nahveiga/black-widow/site/img/poster-video.jpg

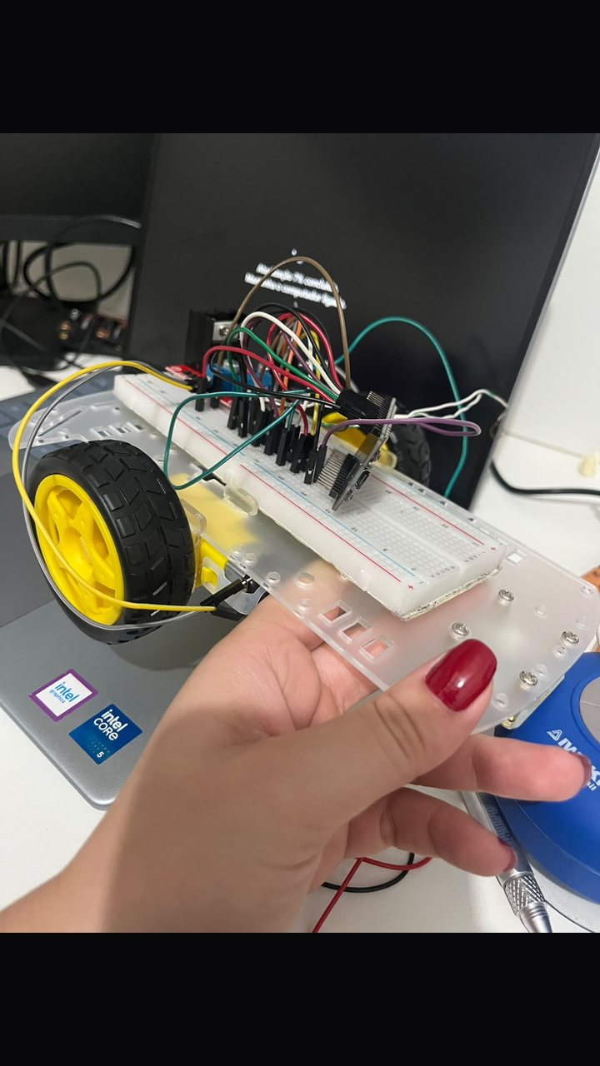
site/img/poster-video.jpg
