nahveiga/black-widow/site/img/prototipo.jpg

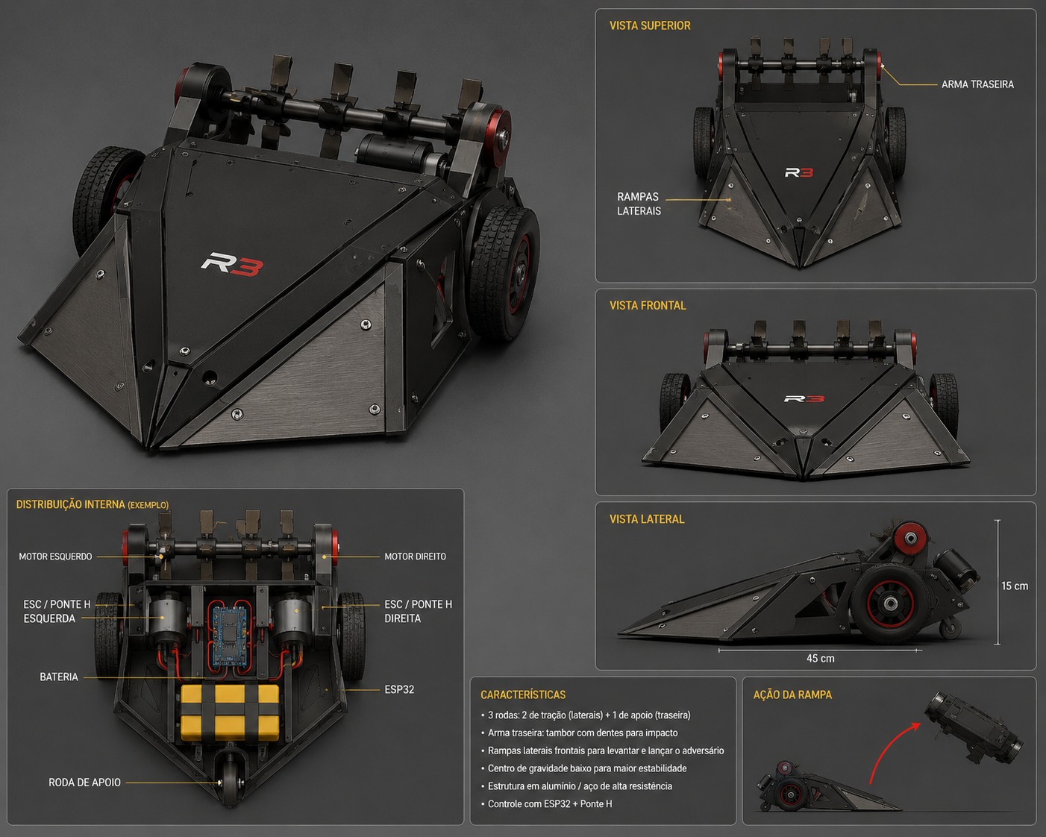
site/img/prototipo.jpg
