nahveiga/black-widow/files/Esquematico_Black_Widow.png

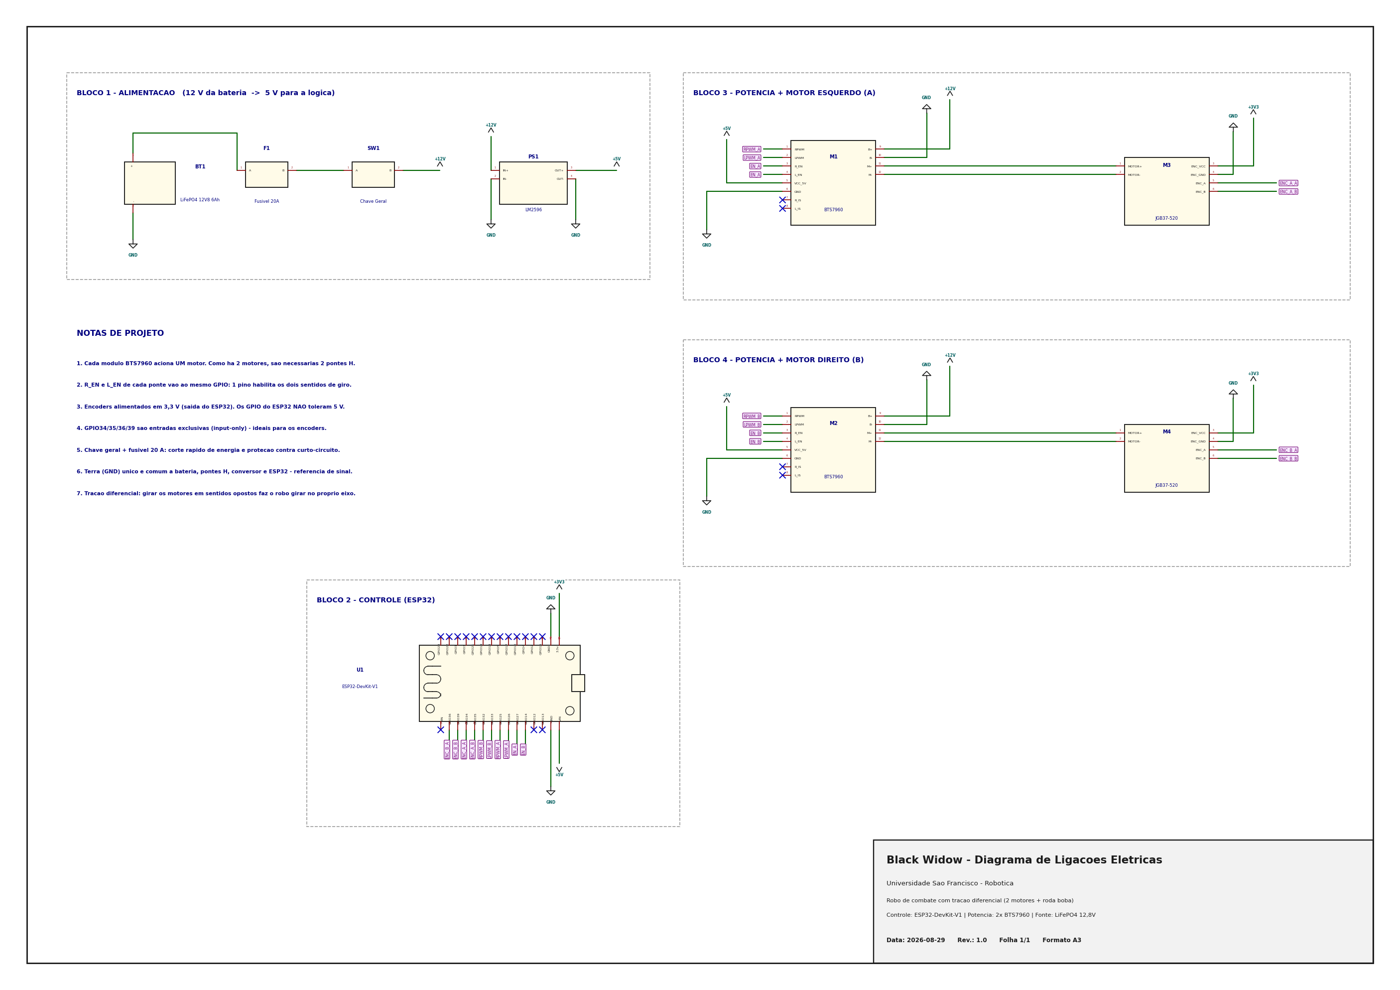
files/Esquematico_Black_Widow.png
