nahveiga/black-widow/files/Modelo_Mecanico_Black_Widow.png

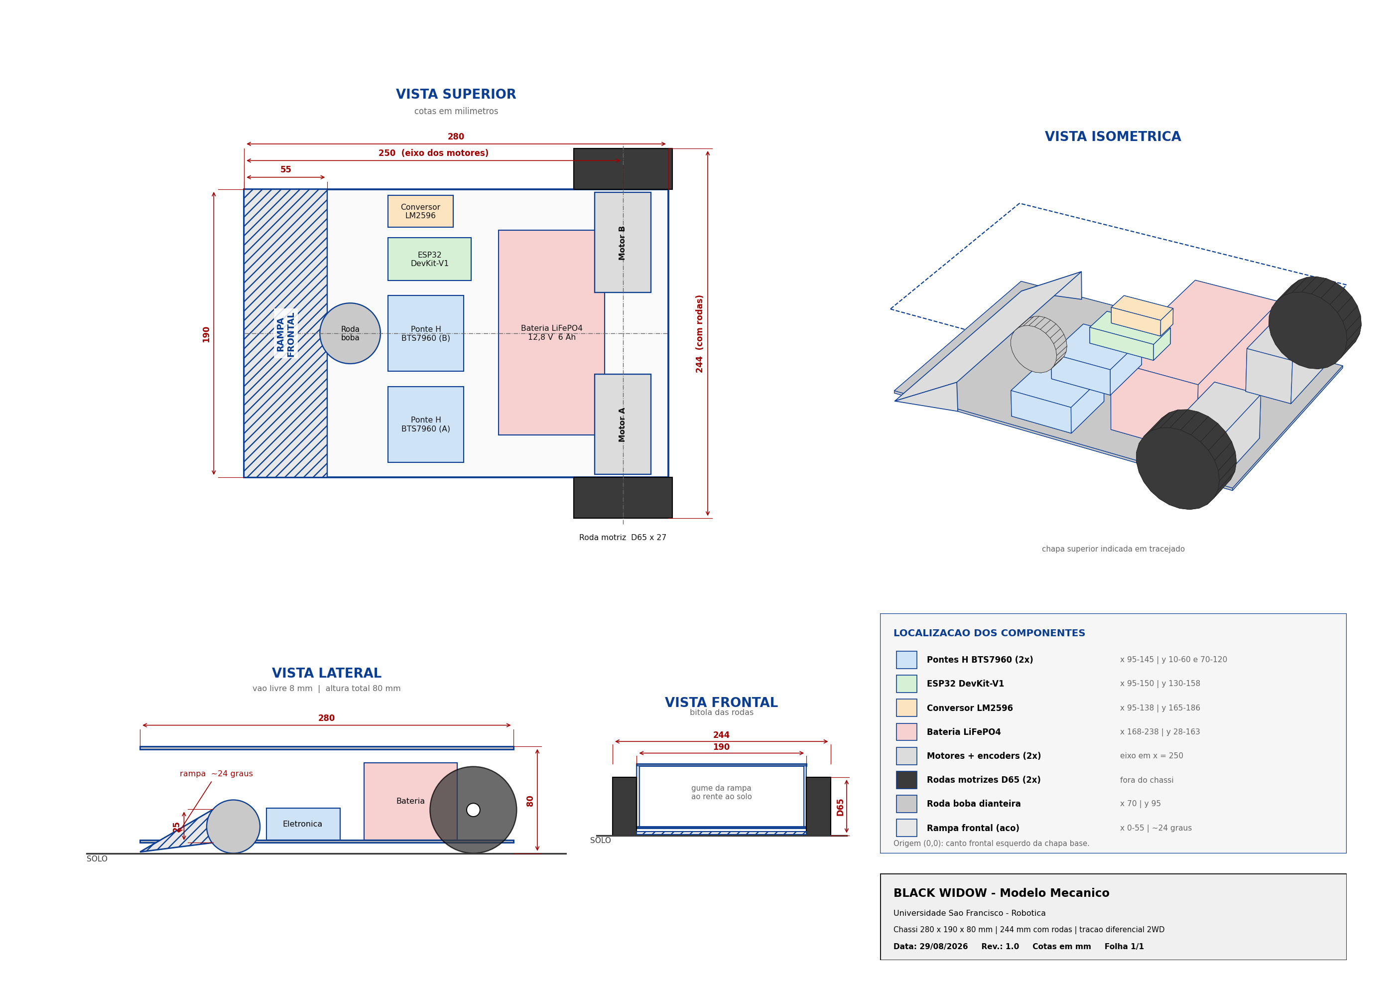
files/Modelo_Mecanico_Black_Widow.png
