nahveiga/black-widow/site/img/eletronica-controle.webp

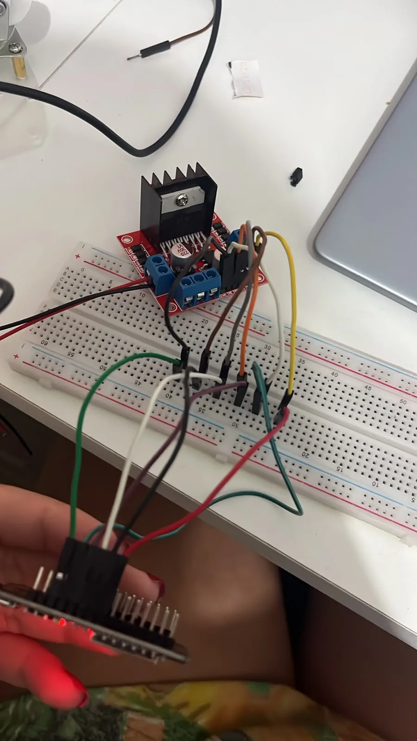
site/img/eletronica-controle.webp
