nahveiga/black-widow/site/img/og-image.jpg

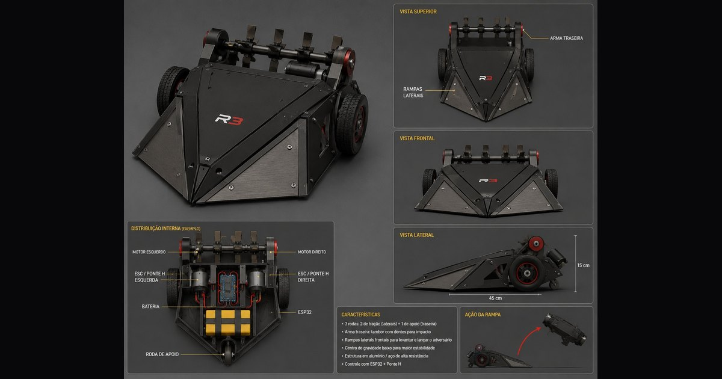
site/img/og-image.jpg
