nahveiga/black-widow/site/img/robo-montado.jpg

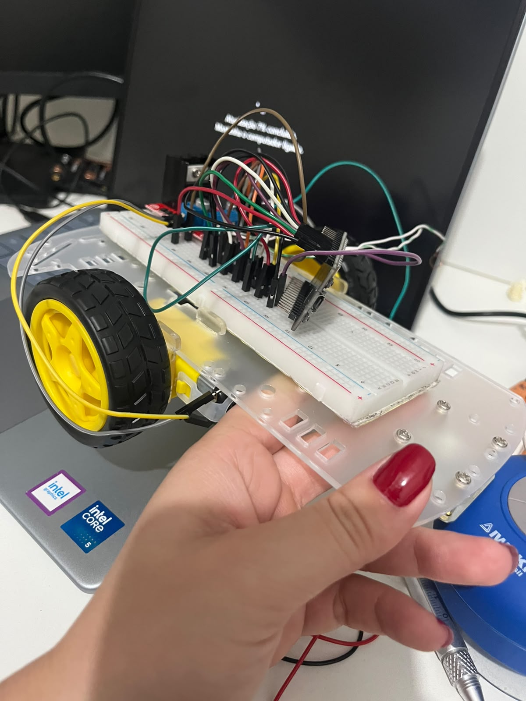
site/img/robo-montado.jpg
