nahveiga/black-widow/site/referencia-prototipo-rotativo/screenshots/01-ang.png

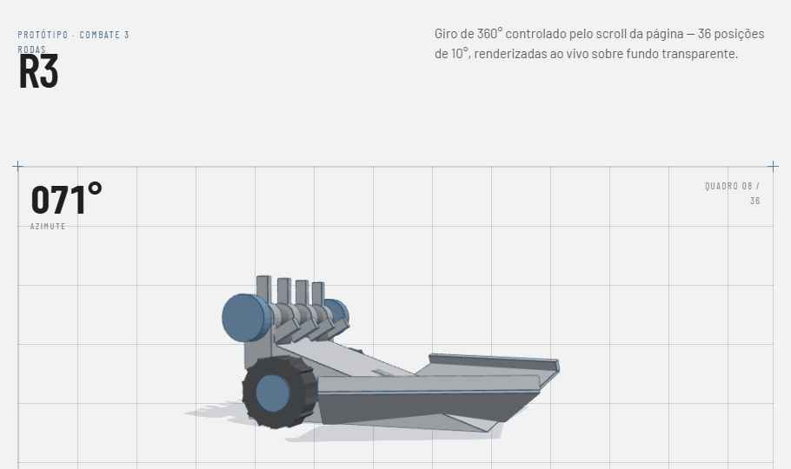
site/referencia-prototipo-rotativo/screenshots/01-ang.png
