nahveiga/black-widow/site/referencia-prototipo-rotativo/screenshots/01-b.png

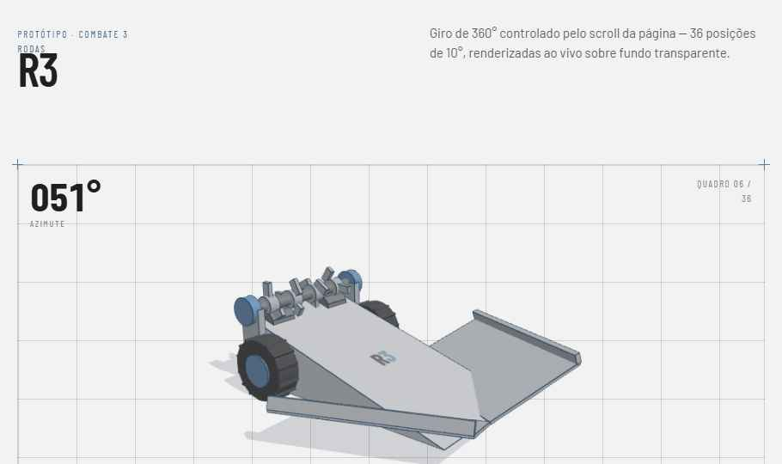
site/referencia-prototipo-rotativo/screenshots/01-b.png
