nahveiga/black-widow/site/referencia-prototipo-rotativo/screenshots/01-real.png

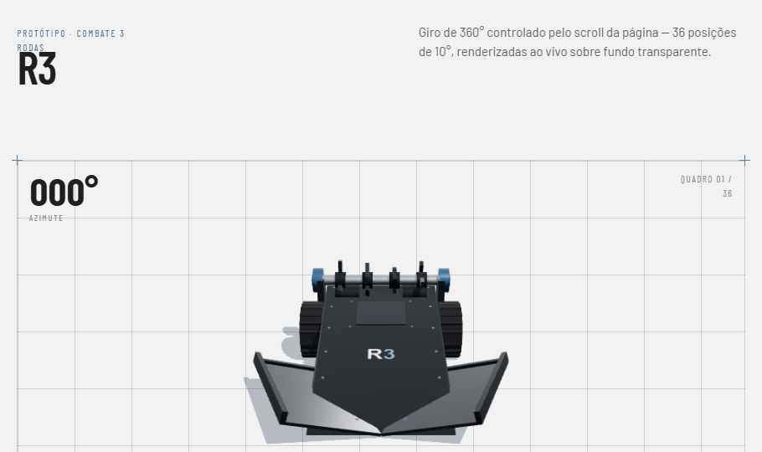
site/referencia-prototipo-rotativo/screenshots/01-real.png
