nahveiga/black-widow/site/referencia-prototipo-rotativo/screenshots/02-ang.png

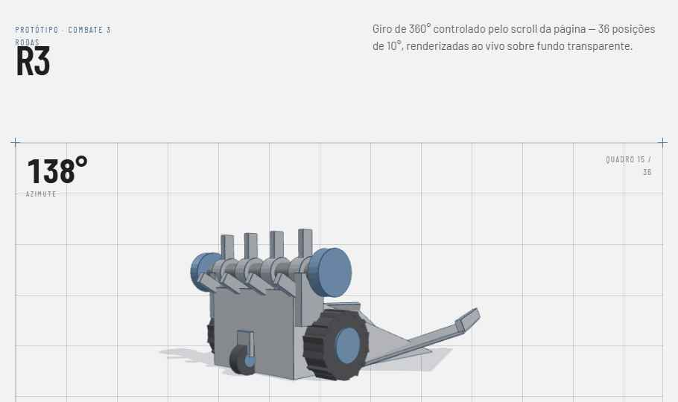
site/referencia-prototipo-rotativo/screenshots/02-ang.png
