nahveiga/black-widow/site/referencia-prototipo-rotativo/screenshots/02-b.png

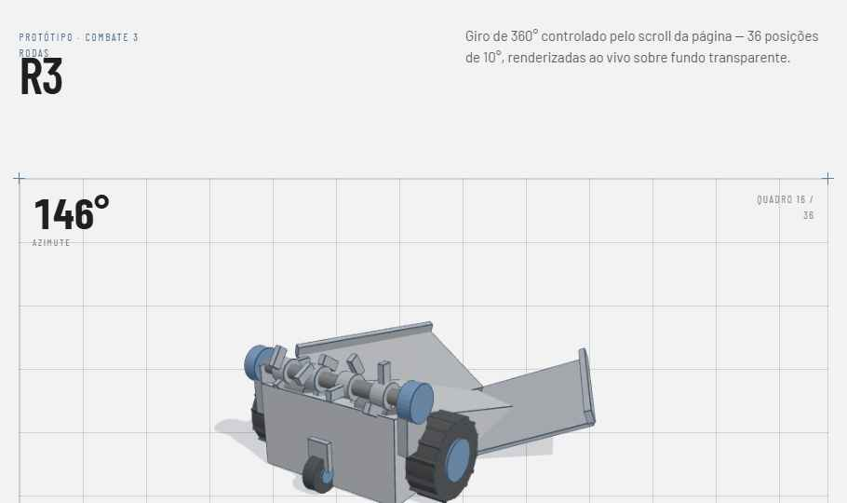
site/referencia-prototipo-rotativo/screenshots/02-b.png
