nahveiga/black-widow/site/referencia-prototipo-rotativo/screenshots/c.png

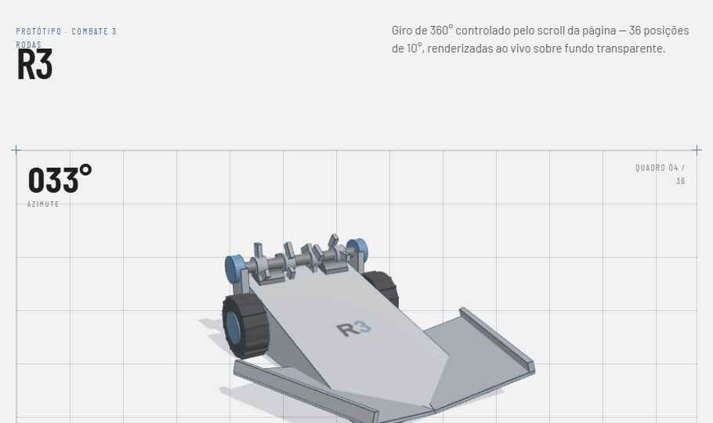
site/referencia-prototipo-rotativo/screenshots/c.png
