nahveiga/black-widow/files/Orcamento_Black_Widow.xlsx

ORCAMENTO - ROBO BLACK WIDOW
Universidade Sao Francisco - Robotica | Teto orcamentario: R$ 1.200,00
Descricao do componente | Quantidade | Preco unitario (R$) | Peso unitario (g) | Valor total (R$) | Peso total (g)
Chapa de aluminio 2 mm (300 x 200 mm) - chassi | 2 | R$75.00 | 320 | R$150.00 | 640 | Base e tampa superior
Motor DC 12 V JGB37-520 COM encoder integrado | 2 | R$155.00 | 220 | R$310.00 | 440 | Tracao + leitura de velocidade
Roda de borracha 65 mm x 27 mm | 2 | R$25.00 | 55 | R$50.00 | 110 | Rodas motrizes
Roda boba (castor) 40 mm | 1 | R$30.00 | 35 | R$30.00 | 35 | Apoio dianteiro
Ponte H BTS7960 43 A | 2 | R$30.00 | 66 | R$60.00 | 132 | 1 modulo por motor
Conversor DC-DC step-down LM2596 | 1 | R$20.00 | 12 | R$20.00 | 12 | 12 V -> 5 V
ESP32 DevKit V1 (30 pinos) | 1 | R$40.00 | 10 | R$40.00 | 10 | Controlador principal
Bateria LiFePO4 12,8 V 6 Ah | 1 | R$250.00 | 900 | R$250.00 | 900 | Alimentacao principal
Chapa de aco 1,5 mm - rampa frontal | 1 | R$60.00 | 260 | R$60.00 | 260 | Arma / dispositivo de ataque
Chave geral + fusivel lamina 20 A | 1 | R$25.00 | 45 | R$25.00 | 45 | Item de seguranca
Parafusos, cabos e conectores | 1 | R$30.00 | 120 | R$30.00 | 120 | Material de montagem
TOTAL |  |  |  | R$1025.00 | 2704
Teto orcamentario (R$) |  |  |  | R$1200.00
Margem restante (R$) |  |  |  | R$175.00
Massa total estimada (kg) |  |  |  | 2.70
OBSERVACOES E PREMISSAS
1. Valores unitarios sao MEDIAS de pesquisa em varejo nacional (Mercado Livre / lojas de eletronica), ago/2026.
2. Sao 2 pontes H BTS7960: cada modulo aciona apenas UM motor. O orcamento inicial do grupo previa 1 unidade.
3. Pesos sao estimativas de catalogo dos fabricantes; confirmar na compra.
4. O encoder NAO aparece em linha separada: o JGB37-520 e vendido com encoder de quadratura ja acoplado.
Compra-lo a parte seria pagar duas vezes pela mesma funcao (a lista inicial do grupo tinha essa duplicidade).
5. Alternativa de menor custo: kit chassi 2WD com encoder (~R$ 67), substituindo motores, rodas e roda boba.
6. Chave geral e fusivel sao itens de seguranca exigidos em competicoes de robos de combate.
7. Celulas em AZUL sao valores de entrada; celulas em preto sao calculadas por formula.
