nahveiga/black-widow/site/arquivos/orcamento-black-widow.xlsx

ORÇAMENTO BLACK WIDOW
Componente | Quantidade | Valor estimado
Carcaça de alumínio (Chapa de carbono) | 2 | R$150
Motores 12 V | 2 | R$220
Rodas | 2 | R$50
3ª roda | 1 | R$30
Ponte H BTS7960 | 1 | R$30
Conversor LM2596 | 1 | R$20
ESP32 | 1 | R$40
Bateria LiFePO4 | 1 | R$250
Encoders | 2 | R$250
TOTAL |  | R$1040
