nahveiga/black-widow/files/Anexos_Black_Widow.pdf

## ORCAMENTO - ROBO BLACK WIDOW

Universidade Sao Francisco - Robotica | Teto orcamentario: R$ 1.200,00
Descricao do componente | Quantidade | Preco unitario (R$)
Chapa de aluminio 2 mm (300 x 200 mm) - chassi | 2 | R$ 75.00
Motor DC 12 V JGB37-520 COM encoder integrado | 2 | R$ 155.00
Roda de borracha 65 mm x 27 mm | 2 | R$ 25.00
Roda boba (castor) 40 mm | 1 | R$ 30.00
Ponte H BTS7960 43 A | 2 | R$ 30.00
Conversor DC-DC step-down LM2596 | 1 | R$ 20.00
ESP32 DevKit V1 (30 pinos) | 1 | R$ 40.00
Bateria LiFePO4 12,8 V 6 Ah | 1 | R$ 250.00
Chapa de aco 1,5 mm - rampa frontal | 1 | R$ 60.00
Chave geral + fusivel lamina 20 A | 1 | R$ 25.00
Parafusos, cabos e conectores | 1 | R$ 30.00

### TOTAL

Teto orcamentario (R$)
Margem restante (R$)
Massa total estimada (kg)

OBSERVACOES E PREMISSAS
1. Valores unitarios sao MEDIAS de pesquisa em varejo nacional (Mercado Livre / lojas de eletronica), ago/2026.
2. Sao 2 pontes H BTS7960: cada modulo aciona apenas UM motor. O orcamento inicial do grupo previa 1 unidade.
3. Pesos sao estimativas de catalogo dos fabricantes; confirmar na compra.
4. O encoder NAO aparece em linha separada: o JGB37-520 e vendido com encoder de quadratura ja acoplado. Compra-lo a parte seria pagar duas vezes pela mesma funcao (a lista inicial do grupo tinha essa duplicidade).
5. Alternativa de menor custo: kit chassi 2WD com encoder (~R$ 67), substituindo motores, rodas e roda boba.
6. Chave geral e fusivel sao itens de seguranca exigidos em competicoes de robos de combate.
7. Celulas em AZUL sao valores de entrada; celulas em preto sao calculadas por formula.

Peso unitario (g) | Valor total (R$) | Peso total (g)
320 | R$ 150.00 | 640 | Base e tampa superior
220 | R$ 310.00 | 440 | Tracao + leitura de velocidade
55 | R$ 50.00 | 110 | Rodas motrizes
35 | R$ 30.00 | 35 | Apoio dianteiro
66 | R$ 60.00 | 132 | 1 modulo por motor
12 | R$ 20.00 | 12 | 12 V -> 5 V
10 | R$ 40.00 | 10 | Controlador principal
900 | R$ 250.00 | 900 | Alimentacao principal
260 | R$ 60.00 | 260 | Arma / dispositivo de ataque
45 | R$ 25.00 | 45 | Item de seguranca
120 | R$ 30.00 | 120 | Material de montagem
| R$ 1,025.00 | 2,704
| R$ 1,200.00
| R$ 175.00
2.70

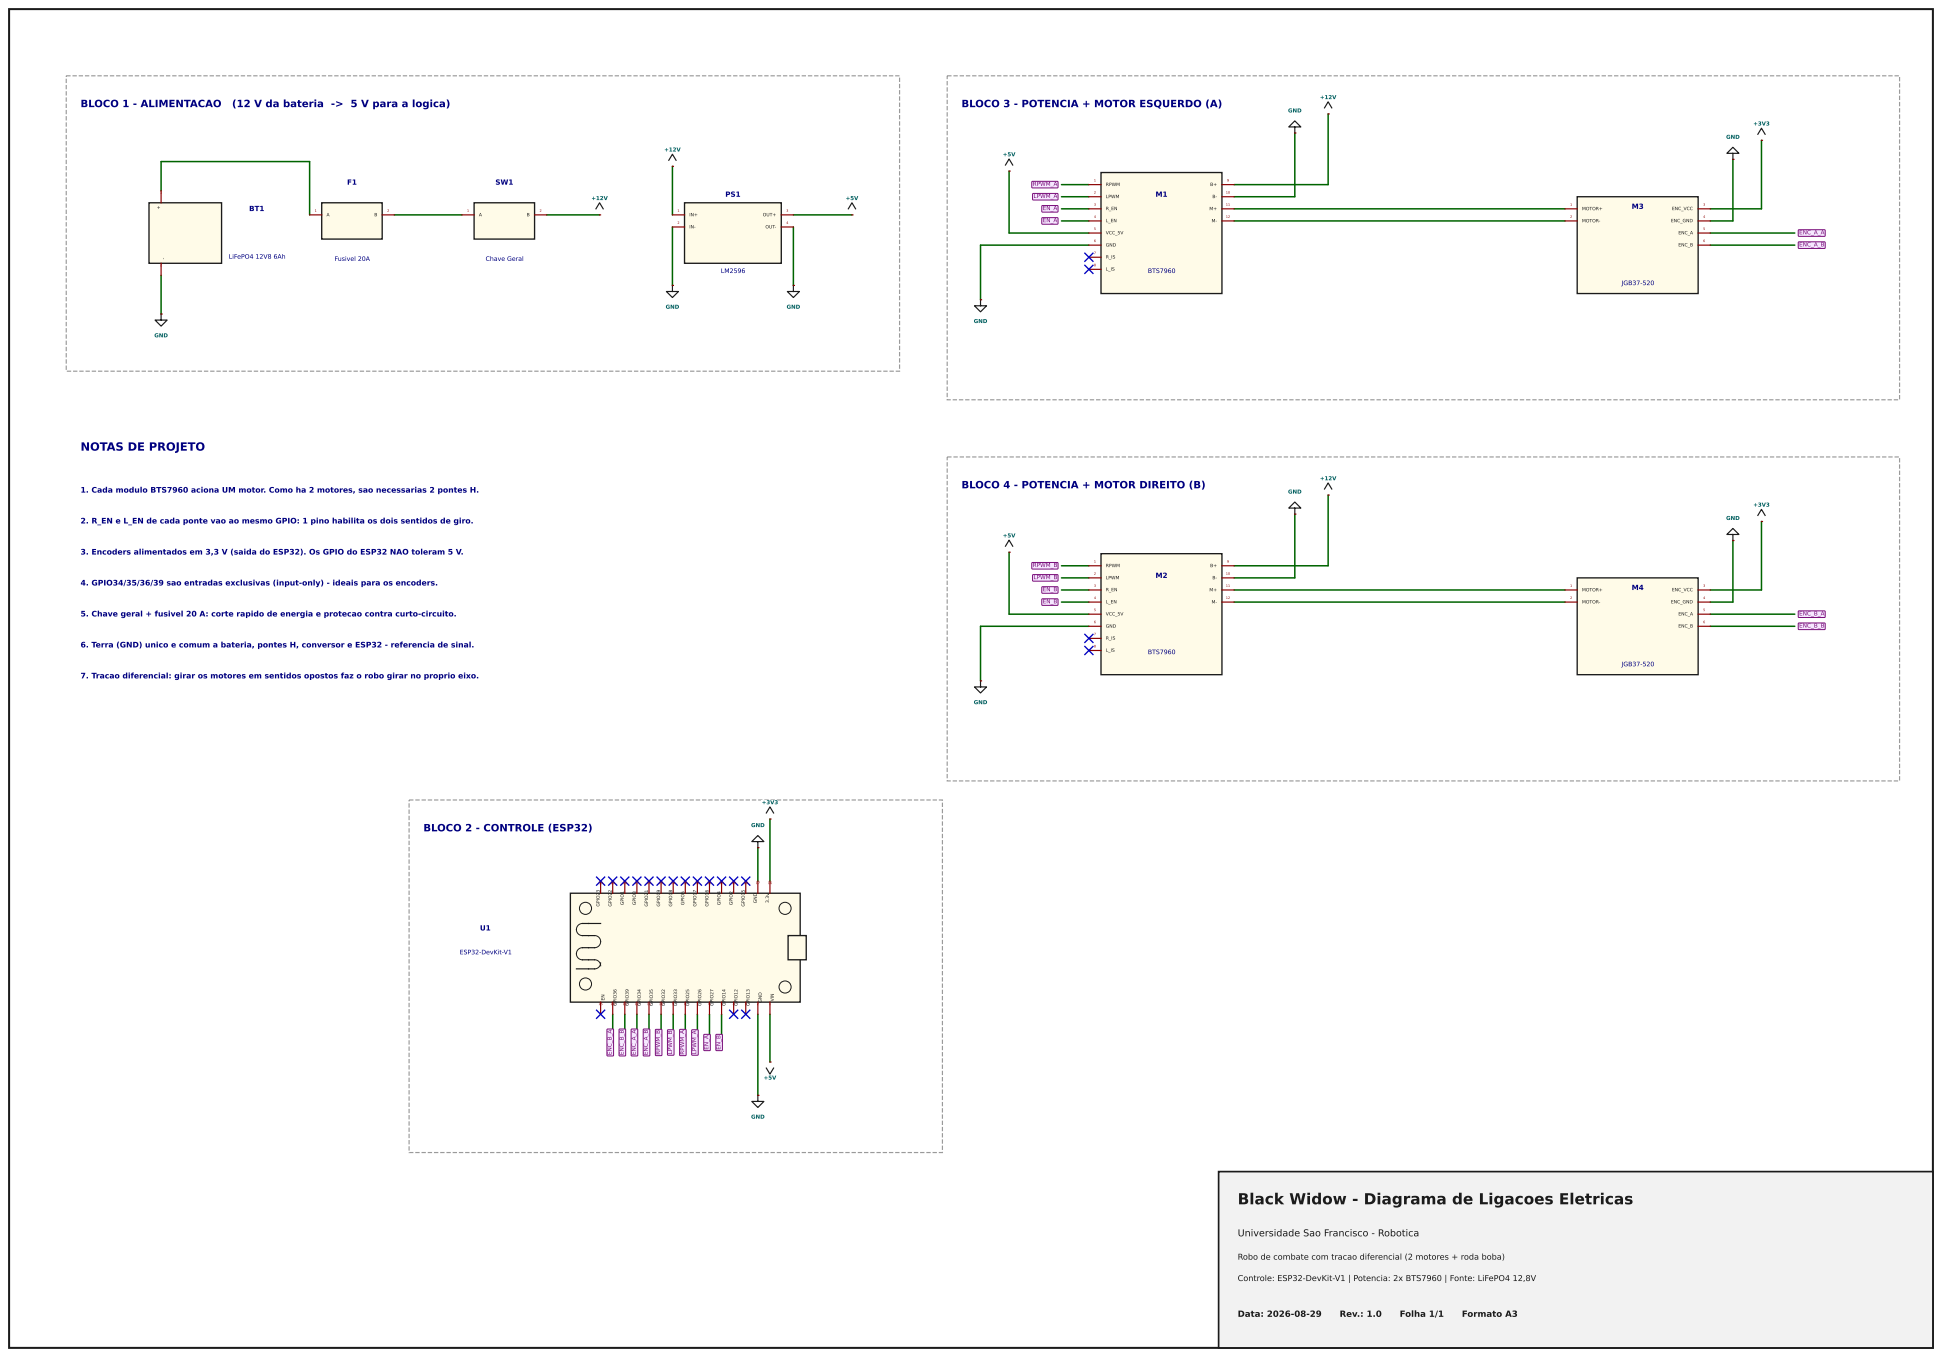
[picture p14: page 3]
OUT+; OUT-; RPWM; LPWM; VCC_5V; GND; MOTOR+; MOTOR-; ENC_VCC; ENC_GND; ENC_A; ENC_B; VIN; 14 GPIO³⁶; 13 GPIO³⁹; 12 GPIO³⁴; 11 GPIO³⁵; 10 GPIO³²; GND 17; GPIO15 18; GPIO2 19; GPIO4 20; GPIO16 21; GPIO17 22; GPIO5 23; GPIO18 24; GPIO19 25; GPIO21 26; GPIO3 27; GPIO1 28; GPIO22 29; 3 GPIO¹³; GPIO23 30; 9 GPIO³³; 8 GPIO²⁵; 7 GPIO²⁶; 6 GPIO²⁷; 5 GPIO¹⁴; 4 GPIO¹²; LiFePO4 12V8 6Ah; Fusivel 20A; Chave Geral; BTS7960; JGB37-520; ESP32-DevKit-V1; RPWM_A; LPWM_A; RPWM_B; LPWM_B; ENC_A_A; ENC_A_B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

NOTAS DE PROJETO

1. Cada modulo BTS7960 aciona UM motor. Como ha 2 motores, sao necessarias 2 pontes H.

BLOCO 4 - POTENCIA + MOTOR DIREITO (B)

2. R_EN e L_EN de cada ponte vao ao mesmo GPIO: 1 pino habilita os dois sentidos de giro.

3. Encoders alimentados em 3,3 V (saida do ESP32). Os GPIO do ESP32 NAO toleram 5 V.

4. GPIO34/35/36/39 sao entradas exclusivas (input-only) - ideais para os encoders.

5. Chave geral + fusivel 20 A: corte rapido de energia e protecao contra curto-circuito.

6. Terra (GND) unico e comum a bateria, pontes H, conversor e ESP32 - referencia de sinal.

7. Tracao diferencial: girar os motores em sentidos opostos faz o robo girar no proprio eixo.

Black Widow - Diagrama de Ligacoes Eletricas

Universidade Sao Francisco - Robotica

Robo de combate com tracao diferencial (2 motores + roda boba)

Controle: ESP32-DevKit-V1 | Potencia: 2x BTS7960 | Fonte: LiFePO4 12,8V

### VISTA SUPERIOR

### VISTA ISOMETRICA

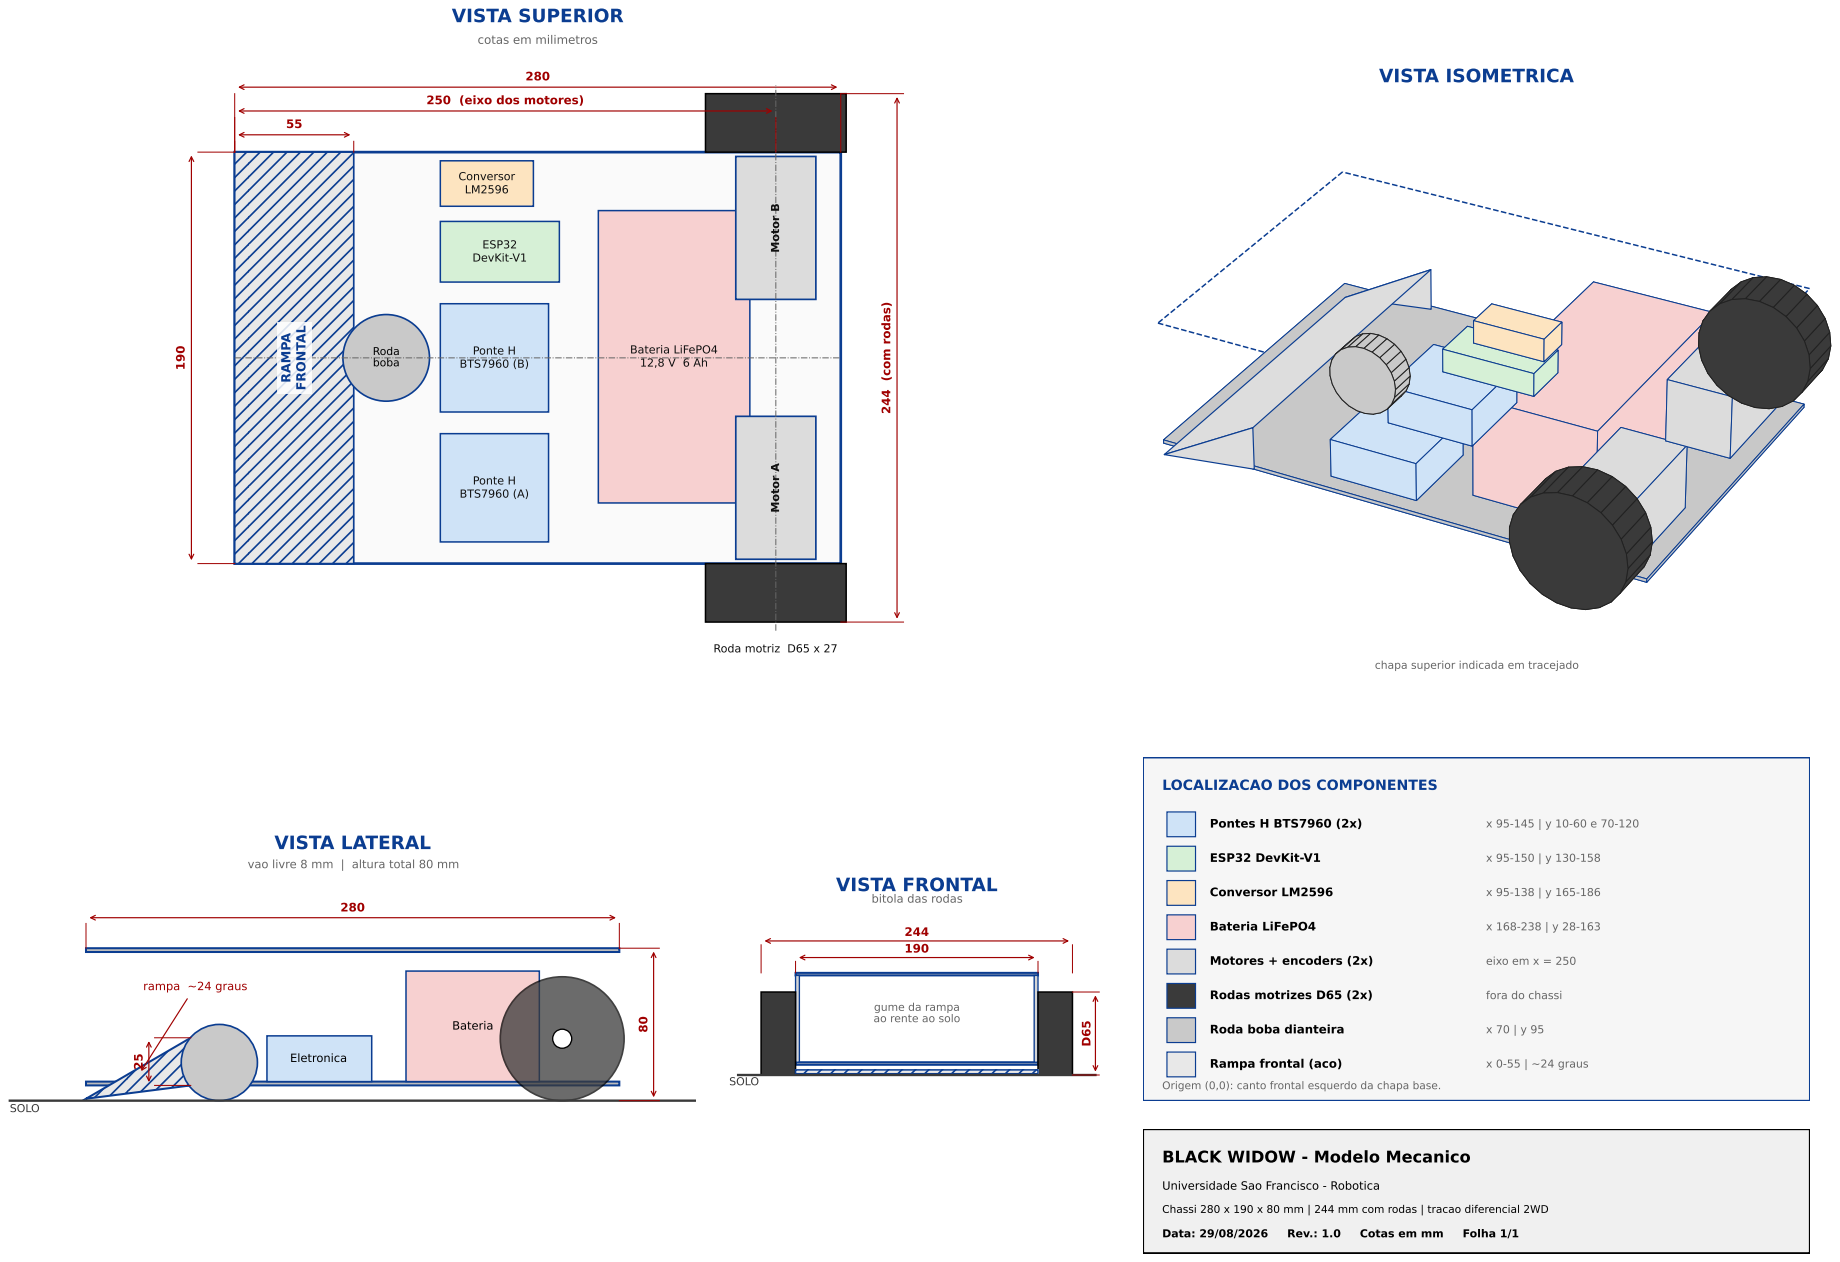
[picture p15: page 4]
RAMPA; FRONTAL; Ponte H BTS7960 (A); Ponte H BTS7960 (B); ESP32 DevKit-V1; Conversor LM2596; Bateria LiFePO4 12,8 V 6 Ah; Motor A Motor B; Roda motriz D65 x 27; Roda boba; 244 (com rodas); SOLO; Bateria; Eletronica; rampa ~24 graus; VISTA LATERAL; VISTA FRONTAL; Pontes H BTS7960 (2x); Bateria LiFePO4; Motores + encoders (2x); eixo em x = 250; Rodas motrizes D65 (2x); fora do chassi; Roda boba dianteira; Rampa frontal (aco); x 0-55 | ~24 graus; Data: 29/08/2026; Rev.: 1.0; Cotas em mm; Folha 1/1

cotas em milimetros

250 (eixo dos motores)

chapa superior indicada em tracejado

LOCALIZACAO DOS COMPONENTES

vao livre 8 mm | altura total 80 mm

bitola das rodas

gume da rampa
ao rente ao solo

Origem (0,0): canto frontal esquerdo da chapa base.

BLACK WIDOW - Modelo Mecanico

Universidade Sao Francisco - Robotica

Chassi 280 x 190 x 80 mm | 244 mm com rodas | tracao diferencial 2WD
