nahveiga/black-widow/files/BlackWidow_KiCad/BlackWidow.kicad_sch

## KiCad design files/BlackWidow_KiCad/BlackWidow.kicad_sch (2026-09-10)

Schematic: BlackWidow.kicad_sch

Parts:
BT1: LiFePO4 12V8 6Ah; LiFePO4_4S
F1: Fusivel 20A; Blade_Mini
M1, M2: BTS7960; BTS7960_43A
M3, M4: JGB37-520; Gearmotor_JGB37
PS1: LM2596; LM2596_Buck
SW1: Chave Geral; SPST_Rocker
U1: ESP32-DevKit-V1; ESP32_30pin

Notes on the sheet:
BLOCO 3 - POTENCIA + MOTOR ESQUERDO (A)
BLOCO 2 - CONTROLE (ESP32)
BLOCO 4 - POTENCIA + MOTOR DIREITO (B)
BLOCO 1 - ALIMENTACAO (12 V da bateria -> 5 V para a logica)
