nahveiga/black-widow/(commit log)

2026-09-10 create dir
    [BlackWidow.kicad_sch, Orcamento_Black_Widow.xlsx]
2026-11-10 codigo final
    alterar depois a variavel de controle
